jaspertan10/2DOF_TiltTable/3d Print/rod holder.3mf

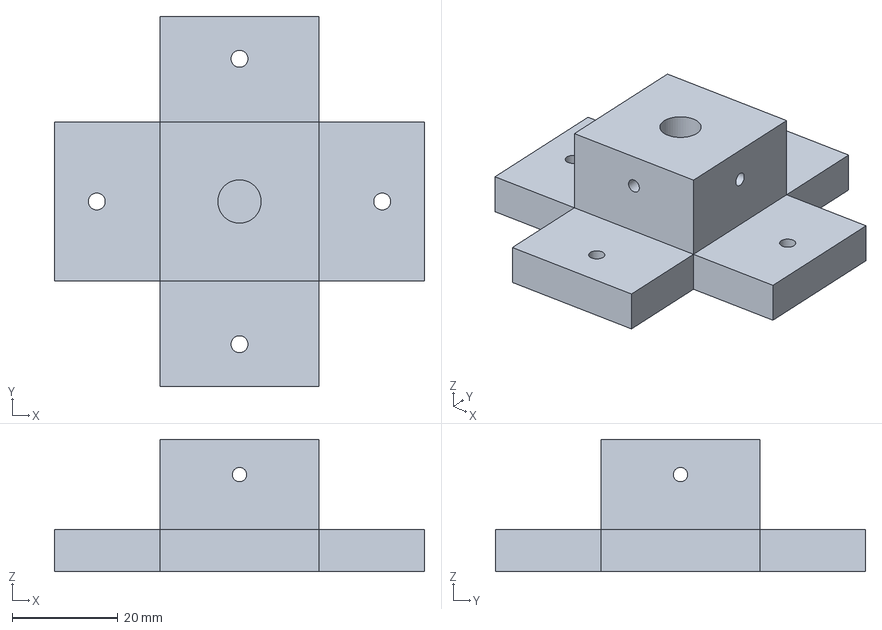
[picture p11: CAD file, 2026-04-08]
3d Print/rod holder.3mf
70.0 x 70.0 x 25.0 mm
