jaspertan10/2DOF_TiltTable/PCB Design/Symbols_and_Footprints/GSB1C411101DSHR/GSB1C411101DSHR.step

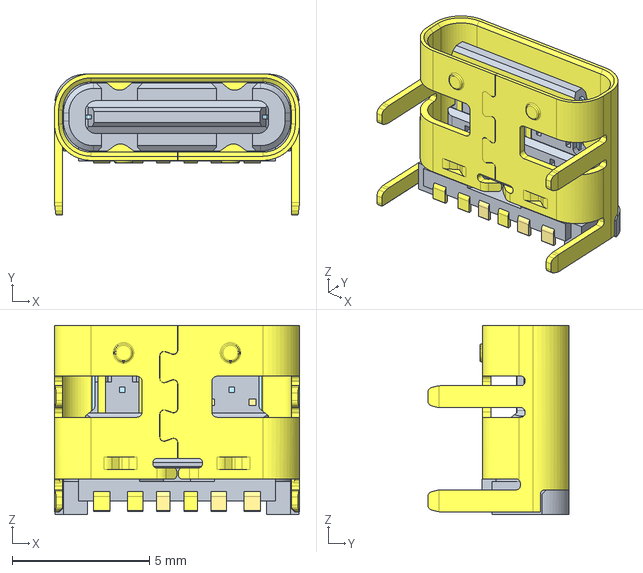
[picture p12: CAD file, 2026-05-03]
PCB Design/Symbols_and_Footprints/GSB1C411101DSHR/GSB1C411101DSHR.step
8.94 x 5.16 x 6.90 mm
