jaspertan10/2DOF_TiltTable/3d Print/servo_mount.3mf

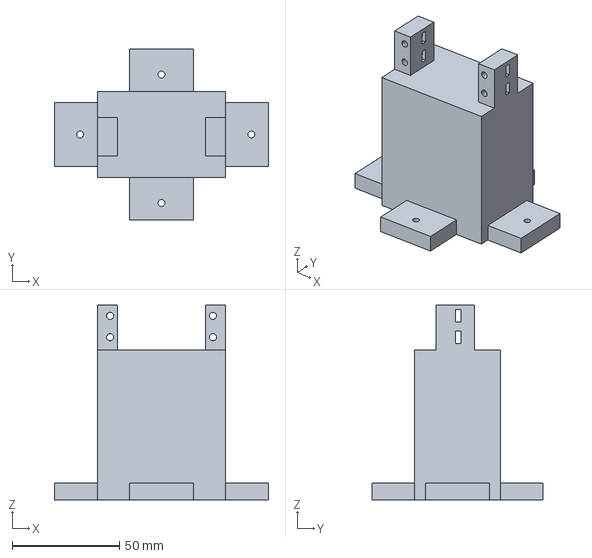
[picture p13: CAD file, 2026-04-08]
3d Print/servo_mount.3mf
100.0 x 80.0 x 91.0 mm
