jaspertan10/2DOF_TiltTable/3d Print/connecting rod bracket.3mf

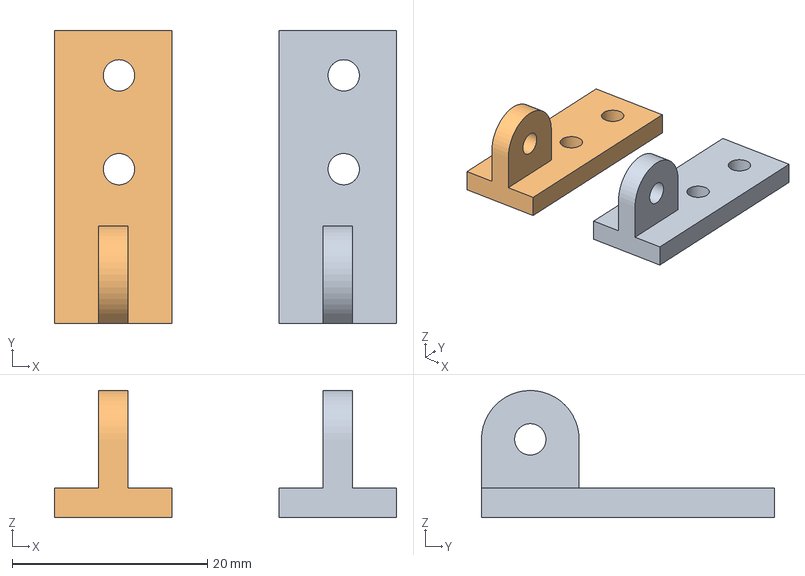
[picture p14: CAD file, 2026-04-08]
3d Print/connecting rod bracket.3mf
35.0 x 30.0 x 13.0 mm
TiltPlate - Connecting Rod Holder.stl x 2
