jaspertan10/2DOF_TiltTable/PCB Design/Symbols_and_Footprints/TPS54531DDA/TPS54531DDA.step

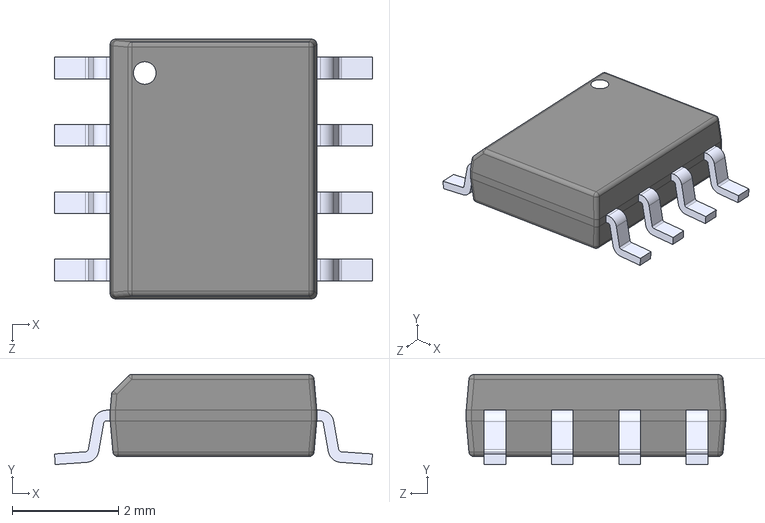
[picture p15: CAD file, 2026-04-08]
PCB Design/Symbols_and_Footprints/TPS54531DDA/TPS54531DDA.step
6.00 x 1.70 x 4.90 mm
