jaspertan10/2DOF_TiltTable/PCB Design/Rev 2/Tilt_Table_PCB_Rev2/Tilt_Table_PCB_Rev2.kicad_pcb

## KiCad design PCB Design/Rev 2/Tilt_Table_PCB_Rev2/Tilt_Table_PCB_Rev2.kicad_pcb (2026-05-05)

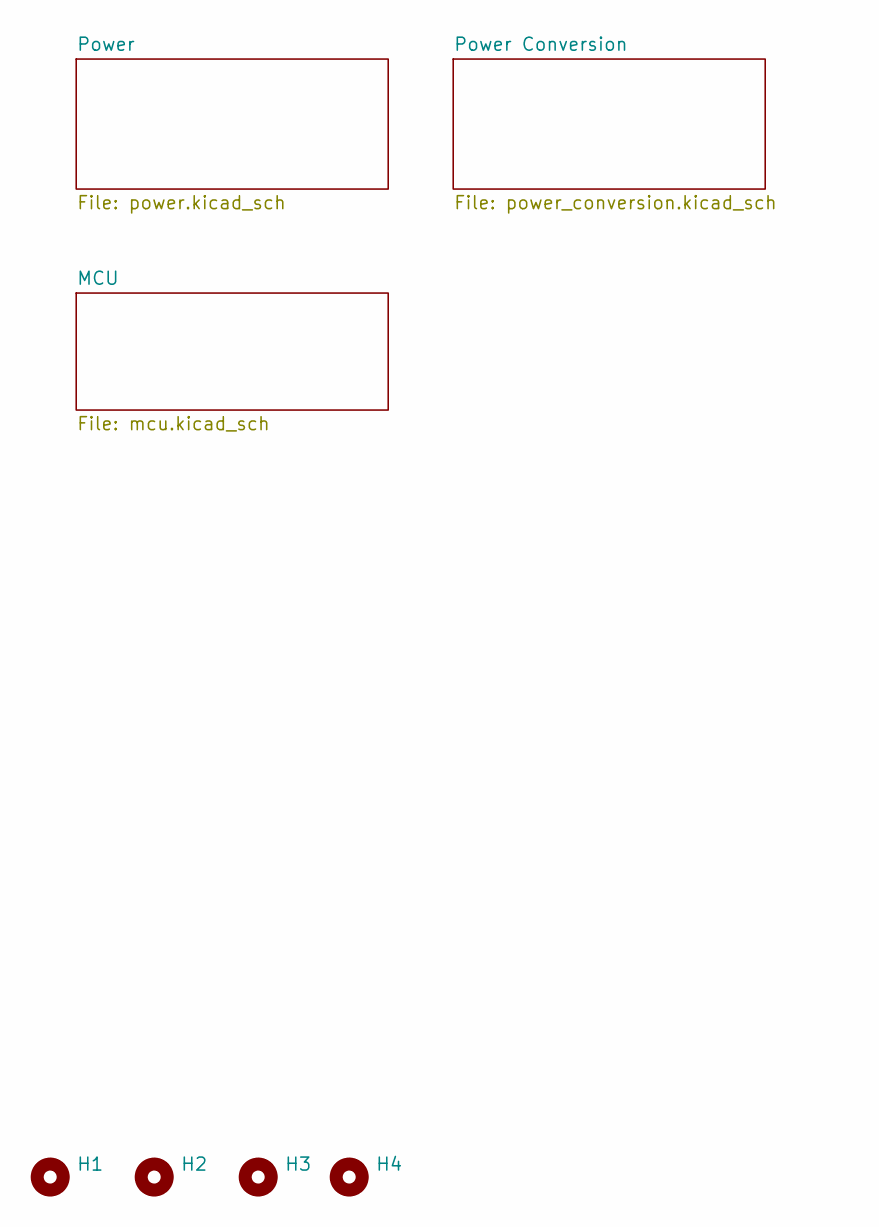
[picture p16: schematic Tilt_Table_PCB_Rev2.kicad_sch, Tilt Plate Board]

Parts:
H1, H2, H3, H4: MountingHole; MountingHole_3.2mm_M3

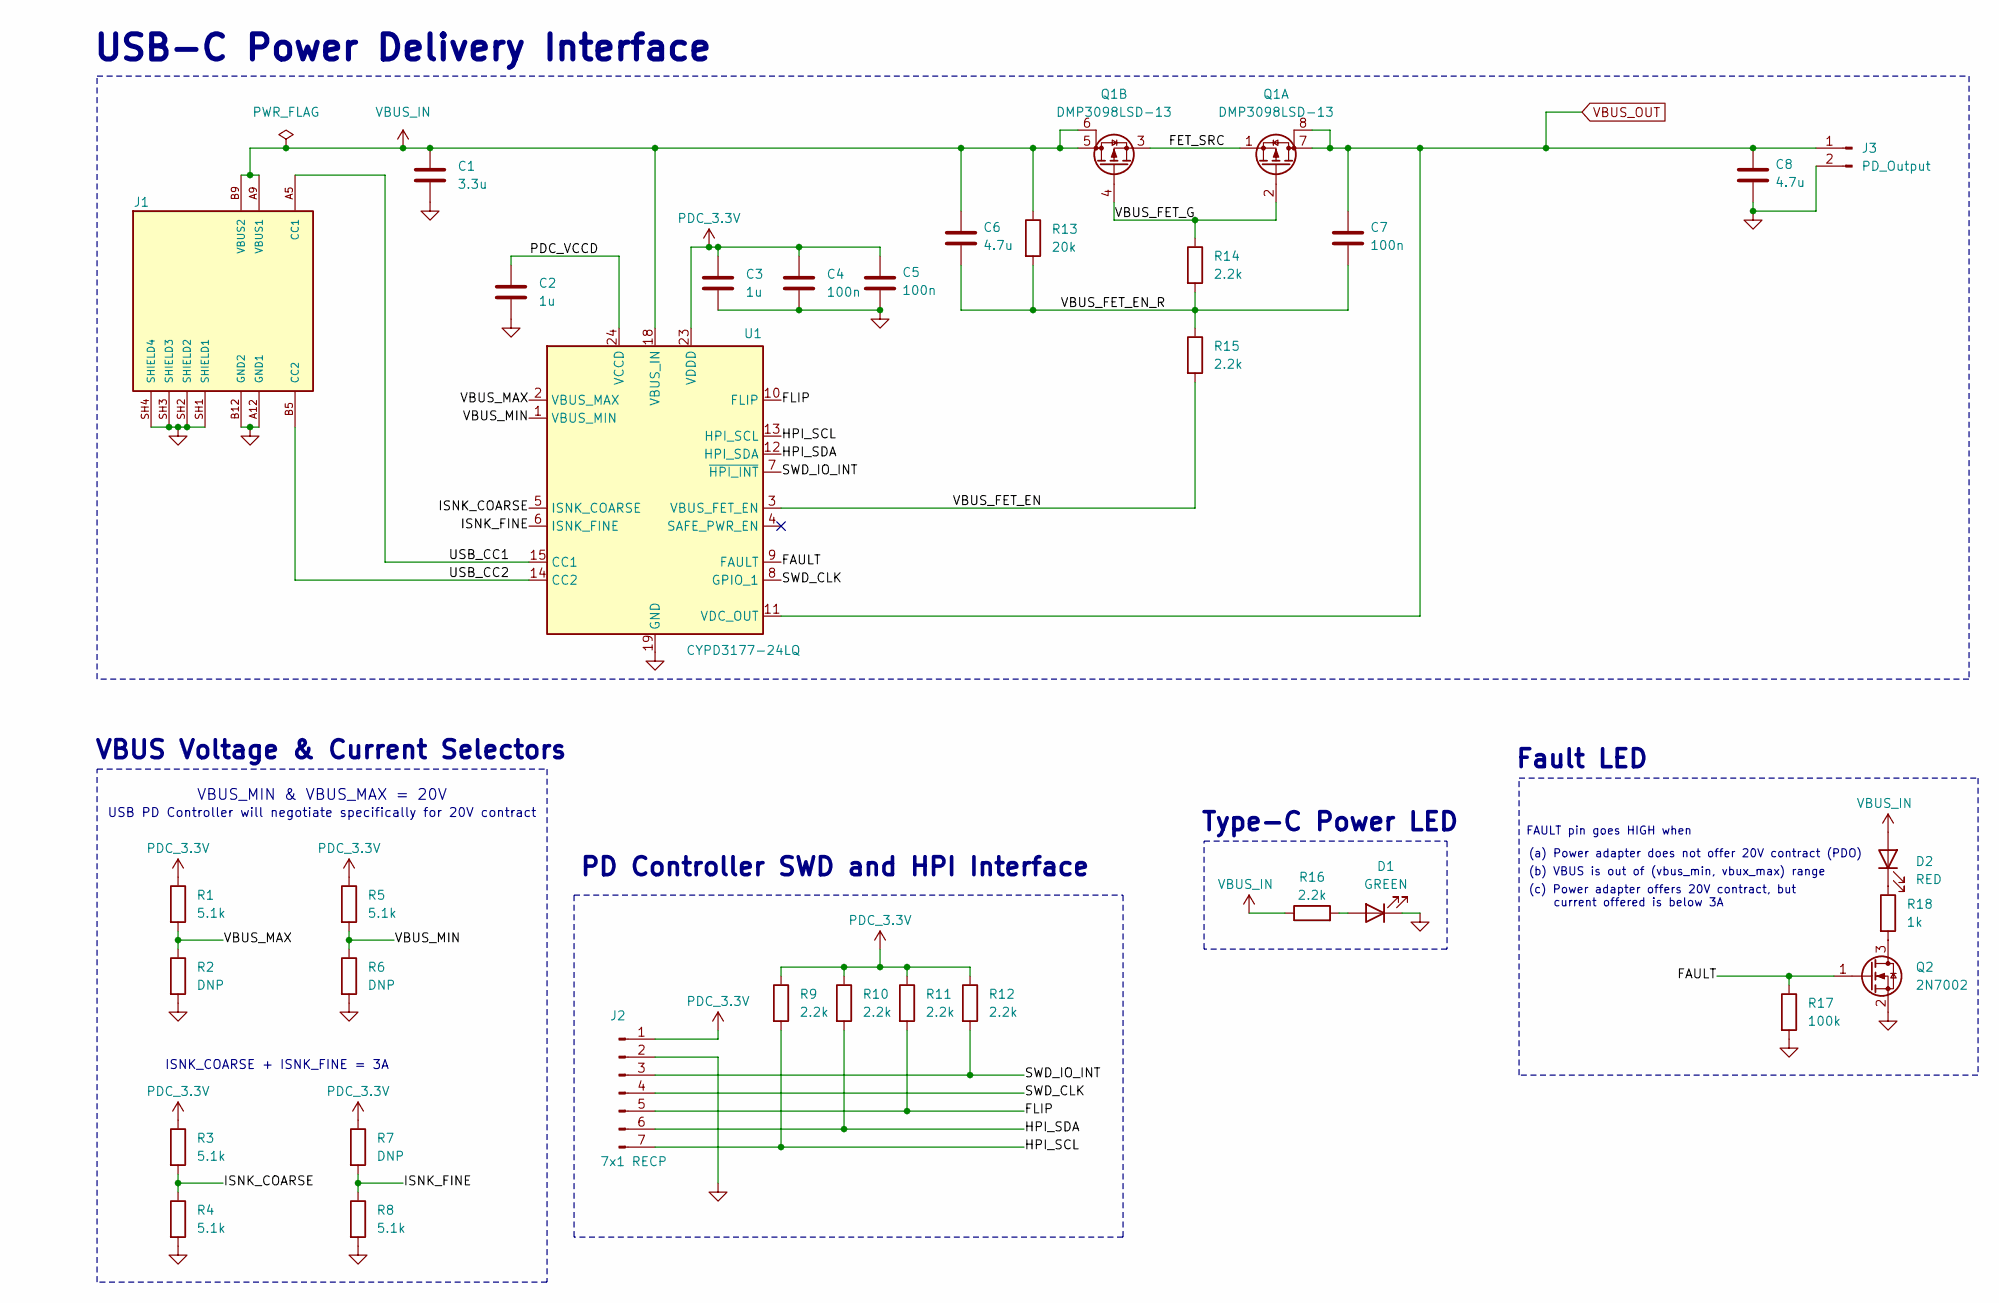
[picture p17: schematic power.kicad_sch, Tilt Plate Board]

Parts:
C1: 3.3u; C_0805_2012Metric
C2, C3: 1u; C_0603_1608Metric
C4, C5, C7: 100n; C_0603_1608Metric
C6, C8: 4.7u; C_0805_2012Metric
D1: GREEN; LED_0603_1608Metric
D2: RED; LED_0603_1608Metric
J1: 2171750001; MOLEX_2171750001; PARTREV A1
J2: 7x1 RECP; PinHeader_1x07_P2.54mm_Vertical
J3: PD_Output; PinHeader_1x02_P2.54mm_Vertical
Q1: DMP3098LSD-13; SOIC127P600X175-8N
Q2: 2N7002; SOT-23
R1, R3, R4, R5, R8: 5.1k; R_0603_1608Metric
R2, R6, R7: DNP; R_0603_1608Metric
R9, R10, R11, R12, R14, R15, R16: 2.2k; R_0603_1608Metric
R13: 20k; R_0603_1608Metric
R17: 100k; R_0603_1608Metric
R18: 1k; R_0603_1608Metric
U1: CYPD3177-24LQ; QFN-24-1EP_4x4mm_P0.5mm_EP2.75x2.75mm

Connections:
/Power/FAULT: Q2.1 (G), R17.1, U1.9 (FAULT)
/Power/FET_SRC: Q1.1 (S), Q1.3 (S)
/Power/FLIP: J2.5, R11.2, U1.10 (FLIP)
/Power/HPI_SCL: J2.7, R9.2, U1.13 (HPI_SCL)
/Power/HPI_SDA: J2.6, R10.2, U1.12 (HPI_SDA)
/Power/ISNK_COARSE: R3.2, R4.1, U1.5 (ISNK_COARSE)
/Power/ISNK_FINE: R7.2, R8.1, U1.6 (ISNK_FINE)
/Power/PDC_VCCD: C2.1, U1.24 (VCCD)
/Power/SWD_CLK: J2.4, U1.8 (GPIO_1)
/Power/SWD_IO_INT: J2.3, R12.2, U1.7 (~HPI_INT)
/Power/USB_CC1: J1.A5 (CC1), U1.15 (CC1)
/Power/USB_CC2: J1.B5 (CC2), U1.14 (CC2)
/Power/VBUS_FET_EN: R15.2, U1.3 (VBUS_FET_EN)
/Power/VBUS_FET_EN_R: C6.2, C7.2, R13.2, R14.2, R15.1
/Power/VBUS_FET_G: Q1.2 (G), Q1.4 (G), R14.1
/Power/VBUS_MAX: R1.2, R2.1, U1.2 (VBUS_MAX)
/Power/VBUS_MIN: R5.2, R6.1, U1.1 (VBUS_MIN)
GND: C1.2, C2.2, C3.2, C4.2, C5.2, C8.2, D1.1 (K), J1.A12 (GND1), J1.B12 (GND2), J1.SH1 (SHIELD1), J1.SH2 (SHIELD2), J1.SH3 (SHIELD3), J1.SH4 (SHIELD4), J2.2, J3.2, Q2.2 (S), R2.2, R4.2, R6.2, R8.2, R17.2, U1.19 (GND), U1.22 (GND), U1.25 (GND); also elsewhere on the board
unnamed: D1.2 (A), R16.2
unnamed: D2.1 (K), R18.1
unnamed: Q2.3 (D), R18.2
PDC_3.3V: C3.1, C4.1, C5.1, J2.1, R1.1, R3.1, R5.1, R7.1, R9.1, R10.1, R11.1, R12.1, U1.23 (VDDD)
VBUS_IN: C1.1, C6.1, D2.2 (A), J1.A9 (VBUS1), J1.B9 (VBUS2), Q1.5 (D), Q1.6 (D), R13.1, R16.1, U1.18 (VBUS_IN)
VBUS_OUT: C7.1, C8.1, J3.1, Q1.7 (D), Q1.8 (D), U1.11 (VDC_OUT); also elsewhere on the board

Notes on the sheet:
Type-C Power LED
Fault LED
(c) Power adapter offers 20V contract, but current offered is below 3A
USB PD Controller will negotiate specifically for 20V contract
ISNK_COARSE + ISNK_FINE = 3A
VBUS Voltage & Current Selectors
VBUS_MIN & VBUS_MAX = 20V
PD Controller SWD and HPI Interface
FAULT pin goes HIGH when
(b) VBUS is out of (vbus_min, vbux_max) range
USB-C Power Delivery Interface
(a) Power adapter does not offer 20V contract (PDO)

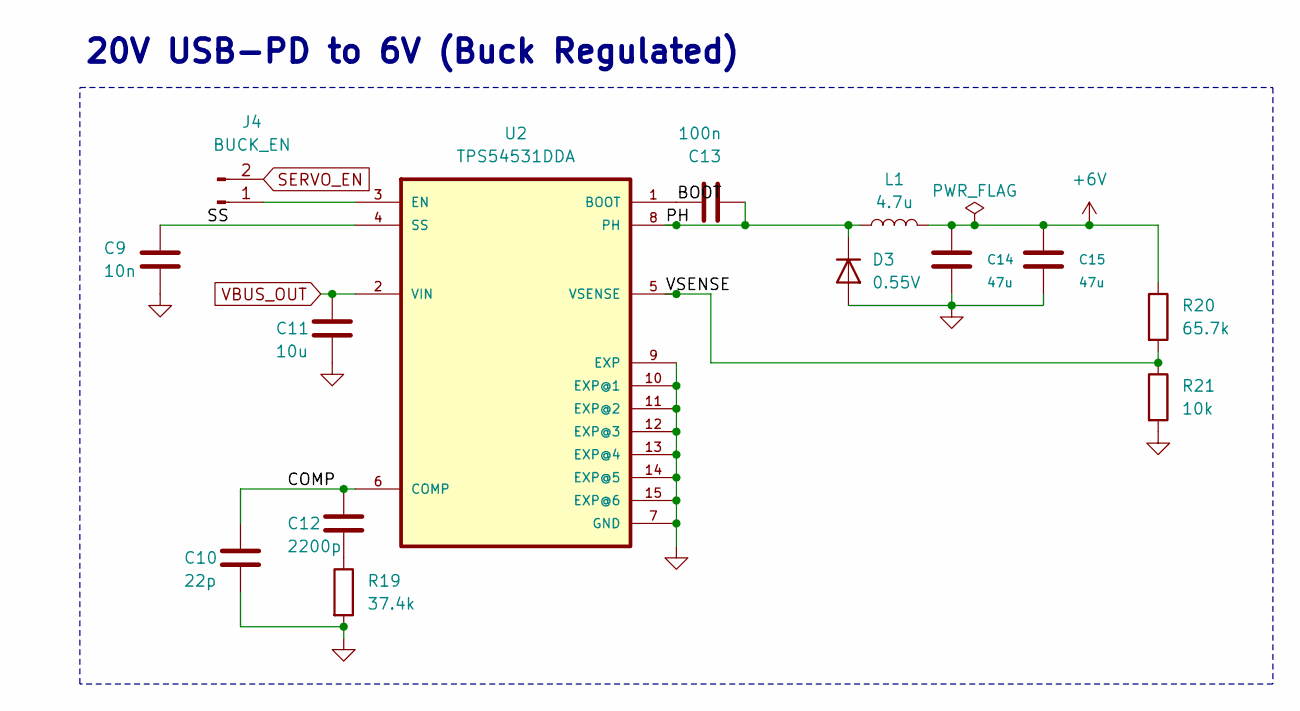
[picture p18: schematic power_conversion.kicad_sch, Tilt Plate Board]

Parts:
C9: 10n; C_0603_1608Metric
C10: 22p; C_0603_1608Metric
C11: 10u; C_0805_2012Metric
C12: 2200p; C_0603_1608Metric
C13: 100n; C_0603_1608Metric
C14, C15: 47u; C_0805_2012Metric
D3: 0.55V; DIOM7959X262N
J4: BUCK_EN; PinHeader_1x02_P2.54mm_Vertical
L1: 4.7u; IND_SRR1240-4R7M
R19: 37.4k; R_0603_1608Metric
R20: 65.7k; R_0603_1608Metric
R21: 10k; R_0603_1608Metric
U2: TPS54531DDA; VREG_LM5017MR_NOPB

Connections:
+6V: C14.1, C15.1, L1.2, R20.1; also elsewhere on the board
/Power Conversion/BOOT: C13.1, U2.1 (BOOT)
/Power Conversion/COMP: C10.1, C12.1, U2.6 (COMP)
/Power Conversion/PH: C13.2, D3.1 (K), L1.1, U2.8 (PH)
/Power Conversion/SS: C9.1, U2.4 (SS)
/Power Conversion/VSENSE: R20.2, R21.1, U2.5 (VSENSE)
GND: C9.2, C10.2, C11.2, C14.2, C15.2, D3.2 (A), R19.2, R21.2, U2.7 (GND), U2.9 (EXP), U2.10 (EXP@1), U2.11 (EXP@2), U2.12 (EXP@3), U2.13 (EXP@4), U2.14 (EXP@5), U2.15 (EXP@6); also elsewhere on the board
unnamed: C12.2, R19.1
unnamed: J4.1, U2.3 (EN)
SERVO_EN: J4.2; also elsewhere on the board
VBUS_OUT: C11.1, U2.2 (VIN); also elsewhere on the board

Notes on the sheet:
20V USB-PD to 6V (Buck Regulated)

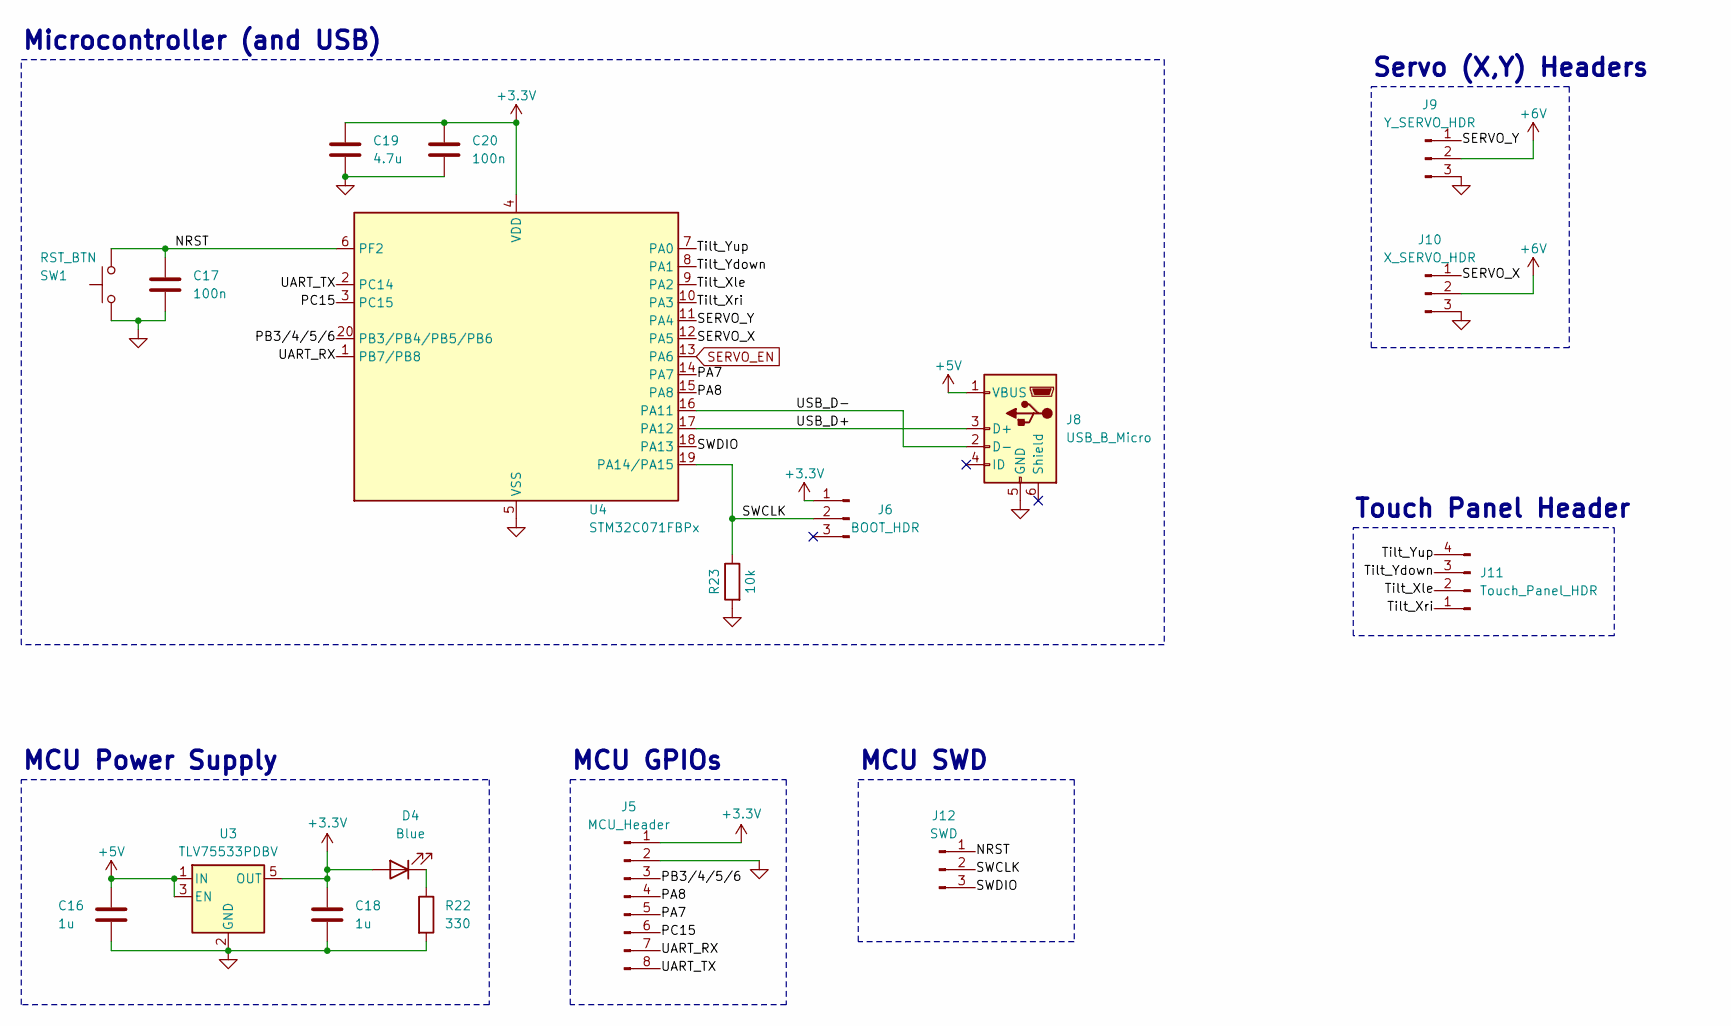
[picture p19: schematic mcu.kicad_sch, Tilt Plate Board]

Parts:
C16, C18: 1u; C_0603_1608Metric
C17, C20: 100n; C_0603_1608Metric
C19: 4.7u; C_0805_2012Metric
D4: Blue; LED_0603_1608Metric
J5: MCU_Header; PinHeader_1x08_P2.54mm_Vertical
J6: BOOT_HDR; PinHeader_1x03_P2.54mm_Vertical
J8: USB_B_Micro; USB_Micro-B_Amphenol_10118194-0001LF_Horizontal
J9: Y_SERVO_HDR; PinHeader_1x03_P2.54mm_Vertical
J10: X_SERVO_HDR; PinHeader_1x03_P2.54mm_Vertical
J11: Touch_Panel_HDR; PinHeader_1x04_P2.54mm_Vertical
J12: SWD; PinHeader_1x03_P2.54mm_Vertical
R22: 330; R_0603_1608Metric
R23: 10k; R_0603_1608Metric
SW1: RST_BTN; SW_SPST_PTS645Sx43SMTR92
U3: TLV75533PDBV; SOT-23-5
U4: STM32C071FBPx; TSSOP-20_4.4x6.5mm_P0.65mm

Connections:
+3.3V: C18.1, C19.1, C20.1, D4.2 (A), J5.1, J6.1, U3.5 (OUT), U4.4 (VDD)
+5V: C16.1, J8.1 (VBUS), U3.1 (IN), U3.3 (EN)
+6V: J9.2, J10.2; also elsewhere on the board
/MCU/NRST: C17.1, J12.1, SW1.2, U4.6 (PF2); also elsewhere on the board
/MCU/PA7: J5.5, U4.14 (PA7)
/MCU/PA8: J5.4, U4.15 (PA8)
/MCU/PB3/4/5/6: J5.3, U4.20 (PB3/PB4/PB5/PB6)
/MCU/PC15: J5.6, U4.3 (PC15)
/MCU/SERVO_X: J10.1, U4.12 (PA5)
/MCU/SERVO_Y: J9.1, U4.11 (PA4)
/MCU/SWCLK: J6.2, J12.2, R23.1, U4.19 (PA14/PA15)
/MCU/SWDIO: J12.3, U4.18 (PA13)
/MCU/Tilt_Xle: J11.2, U4.9 (PA2)
/MCU/Tilt_Xri: J11.1, U4.10 (PA3)
/MCU/Tilt_Ydown: J11.3, U4.8 (PA1)
/MCU/Tilt_Yup: J11.4, U4.7 (PA0)
/MCU/UART_RX: J5.7, U4.1 (PB7/PB8)
/MCU/UART_TX: J5.8, U4.2 (PC14)
/MCU/USB_D+: J8.3 (D+), U4.17 (PA12)
/MCU/USB_D-: J8.2 (D-), U4.16 (PA11)
GND: C16.2, C17.2, C18.2, C19.2, C20.2, J5.2, J8.5 (GND), J9.3, J10.3, R22.2, R23.2, SW1.1, U3.2 (GND), U4.5 (VSS); also elsewhere on the board
unnamed: D4.1 (K), R22.1
SERVO_EN: U4.13 (PA6); also elsewhere on the board

Notes on the sheet:
Microcontroller (and USB)
MCU GPIOs
MCU Power Supply
Servo (X,Y) Headers
Touch Panel Header
MCU SWD

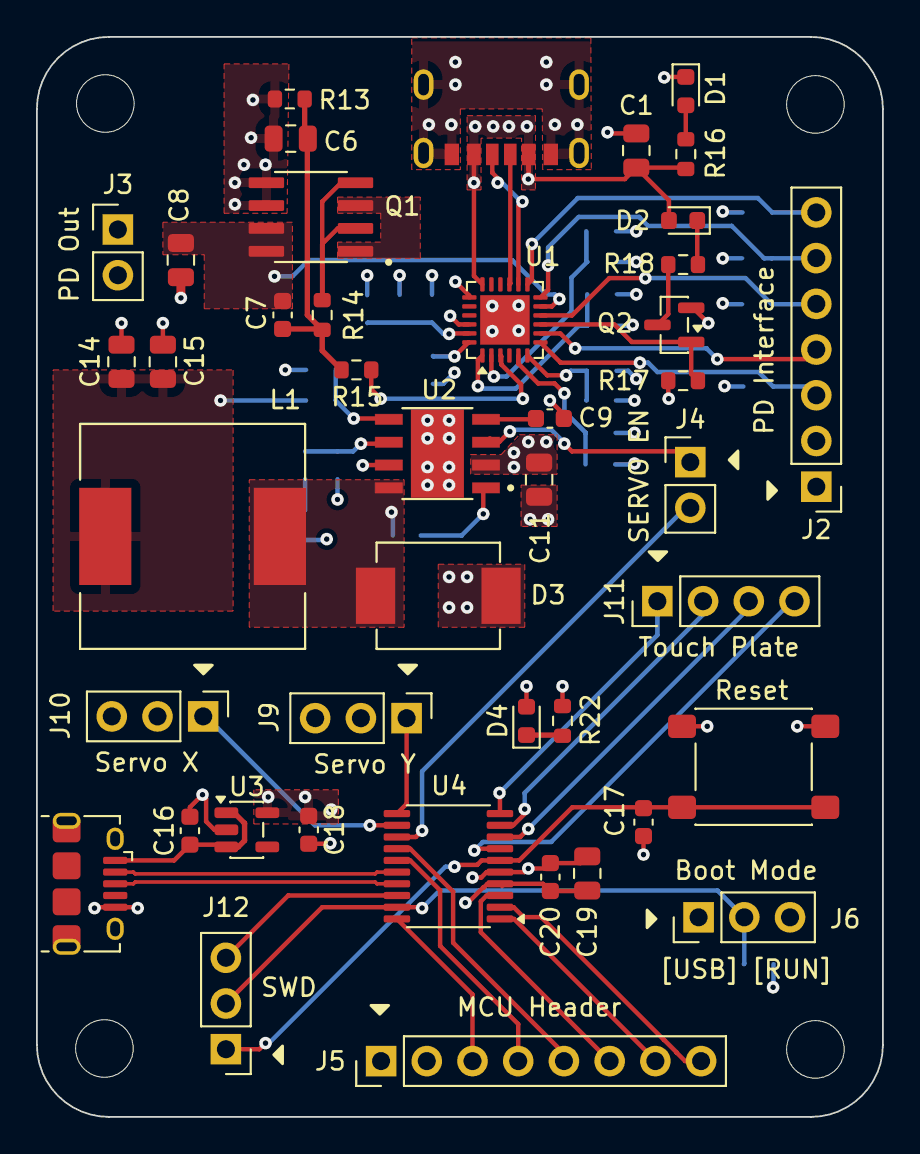
[picture p20: board Tilt_Table_PCB_Rev2.kicad_pcb from above]

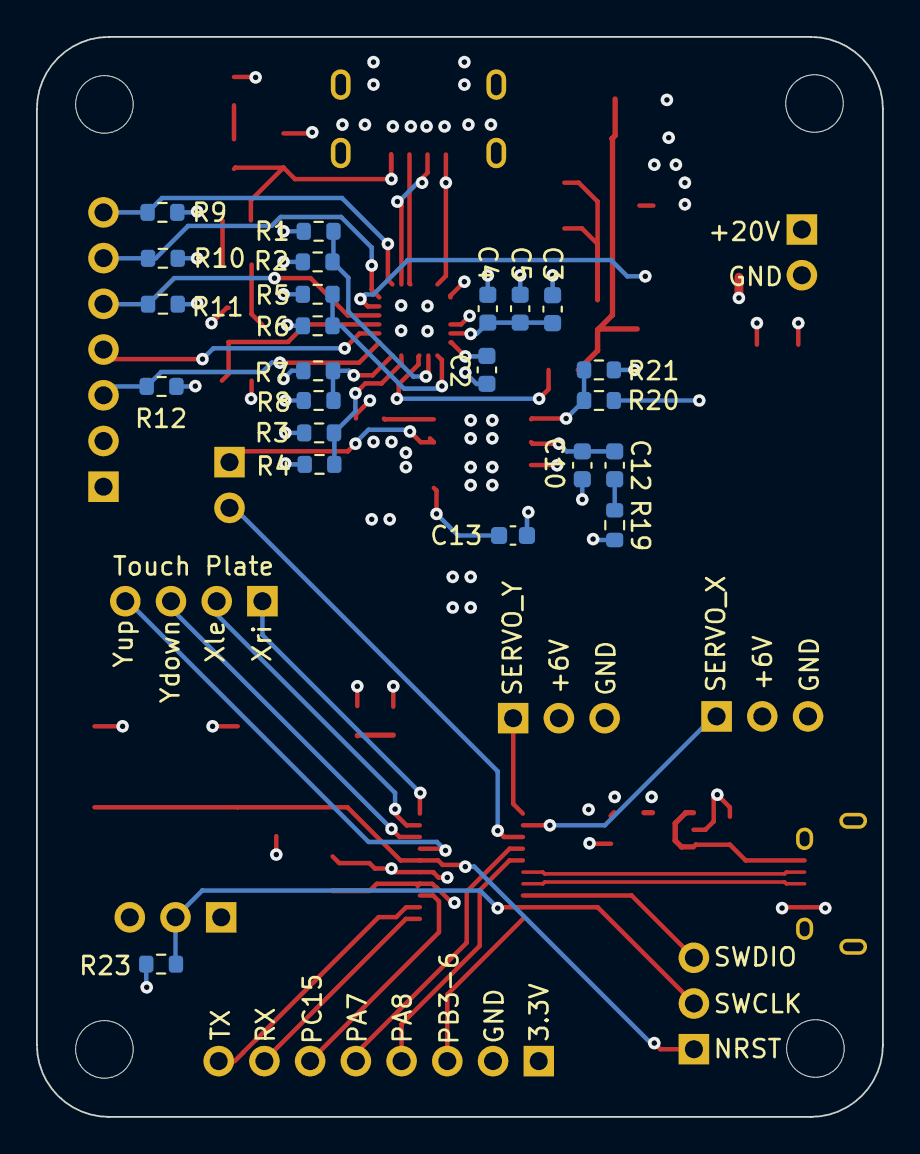
[picture p21: board Tilt_Table_PCB_Rev2.kicad_pcb from below]

Board: 4 copper layers, 47.0 x 60.0 mm, 70 parts (23 on the bottom side), 53 nets.

Other parts of the board:
Reset: RST_BTN; SW_SPST_PTS645Sx43SMTR92

Their connections:
/MCU/NRST: Reset.2; also elsewhere on the board
GND: Reset.1; also elsewhere on the board
