jaspertan10/2DOF_TiltTable/Code/STM32_Code/tilt_plate/Core/Inc/main.h

#define SERVO_EN_Pin GPIO_PIN_0
#define SERVO_EN_GPIO_Port GPIOA
#define SERVO_X_CTRL_Pin GPIO_PIN_1
#define SERVO_X_CTRL_GPIO_Port GPIOA
#define DEBUG_UART_TX_Pin GPIO_PIN_2
#define DEBUG_UART_TX_GPIO_Port GPIOA
#define DEBUG_UART_RX_Pin GPIO_PIN_3
#define DEBUG_UART_RX_GPIO_Port GPIOA
#define SERVO_Y_CTRL_Pin GPIO_PIN_4
#define SERVO_Y_CTRL_GPIO_Port GPIOA
#define Tilt_Yup_Pin GPIO_PIN_5
#define Tilt_Yup_GPIO_Port GPIOA
#define Tilt_Ydown_Pin GPIO_PIN_6
#define Tilt_Ydown_GPIO_Port GPIOA
#define Tilt_Xle_Pin GPIO_PIN_7
#define Tilt_Xle_GPIO_Port GPIOA
#define Tilt_Xri_Pin GPIO_PIN_1
#define Tilt_Xri_GPIO_Port GPIOB
