jaspertan10/2DOF_TiltTable/Code/STM32_Code/tilt_plate/Core/Src/main.c

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
/* Includes ------------------------------------------------------------------*/
#include "main.h"

/* USER CODE BEGIN Includes */
#include "tilt_ctrl.h"
#include "stdio.h"
#include "stdlib.h"
#include "math.h"


/* USER CODE END Includes */

/* USER CODE BEGIN PD */
#define DEBUG_MODE		0

/* USER CODE END PD */

ADC_HandleTypeDef hadc;

TIM_HandleTypeDef htim2;
TIM_HandleTypeDef htim14;
TIM_HandleTypeDef htim16;

UART_HandleTypeDef huart2;

void SystemClock_Config(void);
static void MX_GPIO_Init(void);
static void MX_ADC_Init(void);
static void MX_TIM16_Init(void);
static void MX_USART2_UART_Init(void);
static void MX_TIM2_Init(void);
static void MX_TIM14_Init(void);
/* USER CODE BEGIN 0 */
void delay_us(uint16_t us)
{
	__HAL_TIM_SET_COUNTER(&htim16, 0);
	while (__HAL_TIM_GET_COUNTER(&htim16) < us);
}

static int constrain(int value, int min, int max)
{
	if (value < min)
	{
		return min;
	}
	else if (value > max)
	{
		return max;
	}
	else
	{
		return value;
	}
}

/* USER CODE END 0 */

/**
  * @brief  The application entry point.
  * @retval int
  */
int main(void)
{

  /* USER CODE BEGIN 1 */
#if (DEBUG_MODE != 0)
	int temp_tilt = 0;
	uint8_t tx_buf[100] = {0};
	int len = 0;
#endif

	uint32_t last_loop_time;

  /* USER CODE END 1 */

  /* MCU Configuration--------------------------------------------------------*/

  /* Reset of all peripherals, Initializes the Flash interface and the Systick. */
  HAL_Init();

  /* Configure the system clock */
  SystemClock_Config();

  /* Initialize all configured peripherals */
  MX_GPIO_Init();
  MX_ADC_Init();
  MX_TIM16_Init();
  MX_USART2_UART_Init();
  MX_TIM2_Init();
  MX_TIM14_Init();
  /* USER CODE BEGIN 2 */
  last_loop_time = HAL_GetTick();

  // Enable timer for us delays
  HAL_TIM_Base_Start(&htim16);

  //Enable PWM signal for X Servo Motor Control, then set tilt table to default X position
  HAL_TIM_PWM_Start(&htim2, TIM_CHANNEL_2);
  tilt_x_set_position(TILT_X_SERVO_CENTER);

  //Enable PWM signal for Y Servo Motor Control, then set tilt table to default Y position
  HAL_TIM_PWM_Start(&htim14, TIM_CHANNEL_1);
  tilt_y_set_position(TILT_Y_SERVO_CENTER);


  /* USER CODE END 2 */

  /* Infinite loop */
  /* USER CODE BEGIN WHILE */
  while (1)
  {
#if (DEBUG_MODE != 0)
	  temp_tilt = read_tilt_x_position();
	  len = snprintf((char *)tx_buf, sizeof(tx_buf), "X: %d         ", temp_tilt);
	  HAL_UART_Transmit(&huart2, tx_buf, len, 1000);

	  temp_tilt = read_tilt_y_position();
	  len = snprintf((char *)tx_buf, sizeof(tx_buf), "Y: %d\n", temp_tilt);
	  HAL_UART_Transmit(&huart2, tx_buf, len, 1000);
	  HAL_Delay(500);
#endif
    /* USER CODE END WHILE */

    /* USER CODE BEGIN 3 */


#if 1
	  //100Hz control loop
	  if ((HAL_GetTick() - last_loop_time) < LOOP_PERIOD_MS)
	  {
		  //Wait until LOOP_PERIOD_MS (10ms) has passed
		  continue;
	  }
	  last_loop_time = HAL_GetTick();

	  // Fixed dt in seconds
	  const float dt = LOOP_PERIOD_MS / 1000.0;

	  // Raw reads
	  int raw_x = read_tilt_x_position();
	  int raw_y = read_tilt_y_position();

	  // Start fitlered values as raw
	  int filtered_x = raw_x;
	  int filtered_y = raw_y;

	  // Ensure x and y values are within accepted ranges
	  bool x_range_valid = x_reading_in_range(raw_x);
	  bool y_range_valid = y_reading_in_range(raw_y);

	  // Check if values jump (commonly caused by ball not having enough pressure, i.e. unreliable contact -> jump in reading)
	  bool x_jump_valid = (abs(raw_x - last_good_x) <= X_MAX_STEP);
	  bool y_jump_valid = (abs(raw_y - last_good_y) <= Y_MAX_STEP);


	  // If ball has been picked up and placed, set as new position
	  if (ball_bad_read_count >= BALL_BAD_READ_THRESHOLD)
	  {
		  x_jump_valid = true;
		  y_jump_valid = true;
		  integral_x = 0.0;
		  integral_y = 0.0;
	  }


	  bool good_read = (x_range_valid && x_jump_valid) && (y_range_valid && y_jump_valid);


	  /*** Sensor filtering ***/
	  if (good_read)
	  {
		  //If read is valid, set good x and y points as current raw values
		  last_good_x = raw_x;
		  last_good_y = raw_y;
		  ball_bad_read_count = 0;
	  }
	  else
	  {
		  //Else set filtered x and y to the previous good read point
		  filtered_x = last_good_x;
		  filtered_y = last_good_y;
	  }

	  /*** PID ***/
	  float error_x = setpoint_x_position - filtered_x;
	  float error_y = setpoint_y_position - filtered_y;


	  // Integral term - only accumulates within an active band
	  // No zero reset near set point so accumulated values holds against steady state bias
	  if (good_read && fabsf(error_x) <= INTEGRAL_ACTIVE_BAND)
	  {
		  integral_x += error_x * dt;
	  }
	  if (good_read && fabsf(error_y) <= INTEGRAL_ACTIVE_BAND)
	  {
		  integral_y += error_y * dt;
	  }

	  // Anti windup clamp
	  if (integral_x > INTEGRAL_LIMIT_X) integral_x = INTEGRAL_LIMIT_X;
	  if (integral_x < -INTEGRAL_LIMIT_X) integral_x = -INTEGRAL_LIMIT_X;
	  if (integral_y > INTEGRAL_LIMIT_Y) integral_y = INTEGRAL_LIMIT_Y;
	  if (integral_y < -INTEGRAL_LIMIT_Y) integral_y = -INTEGRAL_LIMIT_Y;


	  // Derivative term - low pass filtered to reduce noise spikes
	  float raw_dx = (error_x - last_error_x) / dt;
	  float raw_dy = (error_y - last_error_y) / dt;

	  // Low pass filter
	  derivative_x = D_FILTER_ALPHA * raw_dx + (1.0 - D_FILTER_ALPHA) * derivative_x;
	  derivative_y = D_FILTER_ALPHA * raw_dy + (1.0 - D_FILTER_ALPHA) * derivative_y;


	  /***** PID Output *****/
	  float output_x = (KpX * error_x) + (KiX * integral_x) + (KdX * derivative_x);
	  float output_y = (KpY * error_y) + (KiY * integral_y) + (KdY * derivative_y);


	  //Save errors for next loop
	  last_error_x = error_x;
	  last_error_y = error_y;


	  //Servo commands
	  int x_servo_cmd = (TILT_X_SERVO_CENTER - output_x);
	  int y_servo_cmd = (TILT_Y_SERVO_CENTER - output_y);


	  x_servo_cmd = constrain(x_servo_cmd, TILT_X_SERVO_MIN, TILT_X_SERVO_MAX);
	  y_servo_cmd = constrain(y_servo_cmd, TILT_Y_SERVO_MIN, TILT_Y_SERVO_MAX);


	  tilt_x_set_position(x_servo_cmd);
	  tilt_y_set_position(y_servo_cmd);

	  if (!good_read)
	  {
		  ball_bad_read_count++;
	  }

#endif


  }
  /* USER CODE END 3 */
}

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
