jaspertan10/2DOF_TiltTable/Code/STM32_Code/tilt_plate/user_files/inc/tilt_ctrl.h

#ifndef TILT_CTRL_H
#define TILT_CTRL_H

#include "stdbool.h"


/* Used for converting desired servo angle to PWM pulse width
	This maps Servo angle: 	0 deg --> 544 pulse width,
							180 deg --> 2400 pulse width

	This provides equation:
		Pulse Width = ((1031 * servo_angle) / 100) + 544 */
#define SERVO_SLOPE_X100 				1031
#define SERVO_OFFSET					544

#define TILT_X_SERVO_CENTER				82
#define TILT_Y_SERVO_CENTER				80

#define TILT_X_SERVO_MIN				(TILT_X_SERVO_CENTER - 10)
#define TILT_X_SERVO_MAX				(TILT_X_SERVO_CENTER + 10)
#define TILT_Y_SERVO_MIN				(TILT_Y_SERVO_CENTER - 10)
#define TILT_Y_SERVO_MAX				(TILT_Y_SERVO_CENTER + 10)

// Valid reading windows
#define X_ADC_VALID_MIN 				1440
#define X_ADC_VALID_MAX 				2320
#define Y_ADC_VALID_MIN 				290
#define Y_ADC_VALID_MAX 				1330

// Max allowed jump per loop
#define X_MAX_STEP						80
#define Y_MAX_STEP						100

// Tilt Plate Middle Position Values
#define TILT_X_MIDDLE_POS				1880
#define TILT_Y_MIDDLE_POS				810


// Ball bad read count threshold
#define BALL_BAD_READ_THRESHOLD			6

// Integral accumulates when error is within this band
// No reset to zero near setpoint - integral will hold its value to correct steady state bias
#define INTEGRAL_ACTIVE_BAND			60.0

// Integral Anti-windup Clamp
#define INTEGRAL_LIMIT_X				5000.0
#define INTEGRAL_LIMIT_Y				5000.0


#define LOOP_PERIOD_MS 					10	//10ms loop time = 100Hz
#define TILT_ADC_SAMPLE_NUM 			5


// Set point of (X, Y) position
extern int setpoint_x_position;
extern int setpoint_y_position;

// Last valid ball position (X, Y)
extern int last_good_x;
extern int last_good_y;

// Counts number of bad reads - if exceeds
extern int ball_bad_read_count;

/***** PID Gains *****/
extern float KpX;
extern float KpY;
extern float KiX;
extern float KiY;
extern float KdX;
extern float KdY;


/***** Control Loop Terms *****/
// Integral Terms
extern float integral_x;
extern float integral_y;

// Derivative Terms
// Last errors for derivative terms
extern float last_error_x;
extern float last_error_y;
//Derivative Low Pass Filter
//0.0 = fully frozen, 1.0 = no filter (raw), 0.15 default value
extern const float D_FILTER_ALPHA;
extern float derivative_x;
extern float derivative_y;



int read_tilt_x_position();
int read_tilt_y_position();

bool x_reading_in_range(int x_input);
bool y_reading_in_range(int y_input);

void tilt_x_set_position(int angle);
void tilt_y_set_position(int angle);










#endif
