jaspertan10/2DOF_TiltTable/Code/STM32_Code/tilt_plate/user_files/src/tilt_ctrl.c

#include "tilt_ctrl.h"
#include "main.h"
#include "stdbool.h"


extern TIM_HandleTypeDef htim2;
extern TIM_HandleTypeDef htim14;
extern ADC_HandleTypeDef hadc;
extern void delay_us(uint16_t us);



// Derivative Terms
// Last errors for derivative terms
float last_error_x = 0.0;
float last_error_y = 0.0;
//Derivative Low Pass Filter
//0.0 = fully frozen, 1.0 = no filter (raw), 0.15 default value
const float D_FILTER_ALPHA = 0.15;
float derivative_x = 0.0;
float derivative_y = 0.0;

// Set point of (X, Y) position
int setpoint_x_position = TILT_X_MIDDLE_POS;
int setpoint_y_position = TILT_Y_MIDDLE_POS;

// Last valid ball position (X, Y)
int last_good_x = TILT_X_MIDDLE_POS;
int last_good_y = TILT_Y_MIDDLE_POS;


// Counts number of bad reads
int ball_bad_read_count = 0;

/***** PID Gains *****/
float KpX = 0.045;
float KpY = 0.045;
float KiX = 0.01;
float KiY = 0.01;
float KdX = 0.03;
float KdY = 0.03;

// Integral Terms
float integral_x = 0.0;
float integral_y = 0.0;


static int servo_angle_to_cmd_us(int angle)
{
	/* Used for converting desired servo angle to PWM pulse width
		This maps Servo angle: 	0 deg --> 544 pulse width,
								180 deg --> 2400 pulse width

		This provides equation:
			Pulse Width = ((1031 * servo_angle) / 100) + 544 */

	return (((SERVO_SLOPE_X100 * angle) / 100) + SERVO_OFFSET);
}


static inline uint8_t get_pin_index(uint16_t GPIO_Pin)
{
	uint8_t index = 0;

	//GPIO_Pin == 0 is invalid
	assert_param(GPIO_Pin != 0);

	while ((GPIO_Pin & 0x1U) == 0U)
	{
		index++;
		GPIO_Pin >>= 1;
	}

	return index;
}



static inline void tilt_set_output(GPIO_TypeDef* GPIOx, uint16_t GPIO_Pin)
{
	int pin_num = get_pin_index(GPIO_Pin);

	//Clear GPIO MODER bits
	GPIOx->MODER &= ~(0x3U << (pin_num * 2));

	//Set GPIO MOde to Output
	GPIOx->MODER |= (0x01U << (pin_num * 2));
}

static inline void tilt_set_analog(GPIO_TypeDef* GPIOx, uint16_t GPIO_Pin)
{
	int pin_num = get_pin_index(GPIO_Pin);

	//Set GPIO MOde to Analog
	GPIOx->MODER |= (0x3U << (pin_num * 2));

}



int read_tilt_x_position()
{
	ADC_ChannelConfTypeDef sConfig = {0};
	uint32_t sum = 0;

	//Set Yup and Ydown as GPIO Outputs
	tilt_set_output(Tilt_Yup_GPIO_Port, Tilt_Yup_Pin);
	tilt_set_output(Tilt_Ydown_GPIO_Port, Tilt_Ydown_Pin);

	//Set Yup to High and Ydown to Low, creating a voltage gradient on the Y plane
	HAL_GPIO_WritePin(Tilt_Yup_GPIO_Port, Tilt_Yup_Pin, GPIO_PIN_RESET);
	HAL_GPIO_WritePin(Tilt_Ydown_GPIO_Port, Tilt_Ydown_Pin, GPIO_PIN_SET);


	//Set Xle and Xri to ADC Inputs
	tilt_set_analog(Tilt_Xle_GPIO_Port, Tilt_Xle_Pin);
	tilt_set_analog(Tilt_Xri_GPIO_Port, Tilt_Xri_Pin);

	//Configure the ADC channel to be read
	sConfig.Channel = ADC_CHANNEL_7; //This sets it so ADC reads Tilt_Xle_Pin, keep in mind results will be same if we read Tilt_Xri_Pin also, same result...
	sConfig.Rank = ADC_RANK_CHANNEL_NUMBER;
	sConfig.SamplingTime = ADC_SAMPLETIME_71CYCLES_5;
	if (HAL_ADC_ConfigChannel(&hadc, &sConfig) != HAL_OK)
	{
		return -1;
	}

	// Let resistive plate settle
	delay_us(300);

	//Start ADC
	if (HAL_ADC_Start(&hadc) != HAL_OK)
	{
		return -1;
	}

	//Dummy read
	if (HAL_ADC_PollForConversion(&hadc, 10) != HAL_OK)
	{
		HAL_ADC_Stop(&hadc);
		return -1;
	}
	(void)HAL_ADC_GetValue(&hadc);


	//Read TILT_ADC_SAMPLE_NUM number of samples, then average it
	for (int i = 0; i < TILT_ADC_SAMPLE_NUM; i++)
	{
		if (HAL_ADC_PollForConversion(&hadc, 10) != HAL_OK)
		{
			HAL_ADC_Stop(&hadc);
			return -1;
		}

		sum += HAL_ADC_GetValue(&hadc);
	}

	//Stop ADC conversion
	HAL_ADC_Stop(&hadc);

	return (int)(sum / TILT_ADC_SAMPLE_NUM);
}

int read_tilt_y_position()
{
	ADC_ChannelConfTypeDef sConfig = {0};
	uint32_t sum = 0;

	//Set Xle and Xri as GPIO Outputs
	tilt_set_output(Tilt_Xle_GPIO_Port, Tilt_Xle_Pin);
	tilt_set_output(Tilt_Xri_GPIO_Port, Tilt_Xri_Pin);

	//Set Xle to High and Xri to Low, creating a voltage gradient on the X plane
	HAL_GPIO_WritePin(Tilt_Xle_GPIO_Port, Tilt_Xle_Pin, GPIO_PIN_RESET);
	HAL_GPIO_WritePin(Tilt_Xri_GPIO_Port, Tilt_Xri_Pin, GPIO_PIN_SET);


	//Set Yup and Ydown to ADC Inputs
	tilt_set_analog(Tilt_Yup_GPIO_Port, Tilt_Yup_Pin);
	tilt_set_analog(Tilt_Ydown_GPIO_Port, Tilt_Ydown_Pin);

	//Configure the ADC channel to be read
	sConfig.Channel = ADC_CHANNEL_5; //This sets it so ADC reads Tilt_Yup_Pin, keep in mind results will be same if we read Tilt_Ydown also, same result...
	sConfig.Rank = ADC_RANK_CHANNEL_NUMBER;
	sConfig.SamplingTime = ADC_SAMPLETIME_71CYCLES_5;
	if (HAL_ADC_ConfigChannel(&hadc, &sConfig) != HAL_OK)
	{
		return -1;
	}

	// Let resistive plate settle
	delay_us(300);

	//Start ADC
	if (HAL_ADC_Start(&hadc) != HAL_OK)
	{
		return -1;
	}

	//Dummy read
	if (HAL_ADC_PollForConversion(&hadc, 10) != HAL_OK)
	{
		HAL_ADC_Stop(&hadc);
		return -1;
	}
	(void)HAL_ADC_GetValue(&hadc);


	//Read TILT_ADC_SAMPLE_NUM number of samples, then average it
	for (int i = 0; i < TILT_ADC_SAMPLE_NUM; i++)
	{
		if (HAL_ADC_PollForConversion(&hadc, 10) != HAL_OK)
		{
			HAL_ADC_Stop(&hadc);
			return -1;
		}

		sum += HAL_ADC_GetValue(&hadc);
	}

	//Stop ADC conversion
	HAL_ADC_Stop(&hadc);

	return (int)(sum / TILT_ADC_SAMPLE_NUM);
}


bool x_reading_in_range(int x_input)
{
	return (x_input >= X_ADC_VALID_MIN && x_input <= X_ADC_VALID_MAX);


}



bool y_reading_in_range(int y_input)
{
	return (y_input >= Y_ADC_VALID_MIN && y_input <= Y_ADC_VALID_MAX);
}


void tilt_x_set_position(int angle)
{
	 __HAL_TIM_SET_COMPARE(&htim2, TIM_CHANNEL_2, servo_angle_to_cmd_us(angle));
}

void tilt_y_set_position(int angle)
{
	__HAL_TIM_SET_COMPARE(&htim14, TIM_CHANNEL_1, servo_angle_to_cmd_us(angle));
}
