jaspertan10/2DOF_TiltTable/(commit log)

2026-04-08 reorganize, add PCB files, initialize stm32 code library
    [TPS54531DDA.step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]
2026-04-26 PCB Rev 2 init
    [TPS54531DDA.step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]
2026-04-26 Rev 2 schematic updated
    [Tilt_Table_PCB_Rev2.kicad_pcb, Tilt_Table_PCB_Rev2.kicad_sch, mcu.kicad_sch, power.kicad_sch, power_conversion.kicad_sch]
2026-05-03 PCB Rev 2 Update
    [GSB1C411101DSHR.step, TPS54531DDA.step, Tilt_Table_PCB_Rev2.kicad_pcb, Tilt_Table_PCB_Rev2.kicad_sch, mcu.kicad_sch, power.kicad_sch, power_conversion.kicad_sch]
2026-05-05 PCB Rev 2 Layout Complete - Prior to PCB Order
    [Tilt_Table_PCB_Rev2.kicad_pcb, mcu.kicad_sch, power.kicad_sch]
2026-05-05 Final rev2 - submitted to jlcpcb for fab
    [Tilt_Table_PCB_Rev2-B_Cu.gbl, Tilt_Table_PCB_Rev2-B_Mask.gbs, Tilt_Table_PCB_Rev2-B_Paste.gbp, Tilt_Table_PCB_Rev2-B_Silkscreen.gbo, Tilt_Table_PCB_Rev2-Edge_Cuts.gm1, Tilt_Table_PCB_Rev2-F_Cu.gtl, Tilt_Table_PCB_Rev2-F_Mask.gts, Tilt_Table_PCB_Rev2-F_Paste.gtp]
