jaspertan10/2DOF_TiltTable/(notices)

Notices in the files:
Code/STM32_Code/tilt_plate/Core/Src/main.c:
Copyright (c) 2026 STMicroelectronics.
All rights reserved.
This software is licensed under terms that can be found in the LICENSE file
